NTT-BK20/RaspiTank/raspitank_description/meshes/right_wheel.stl

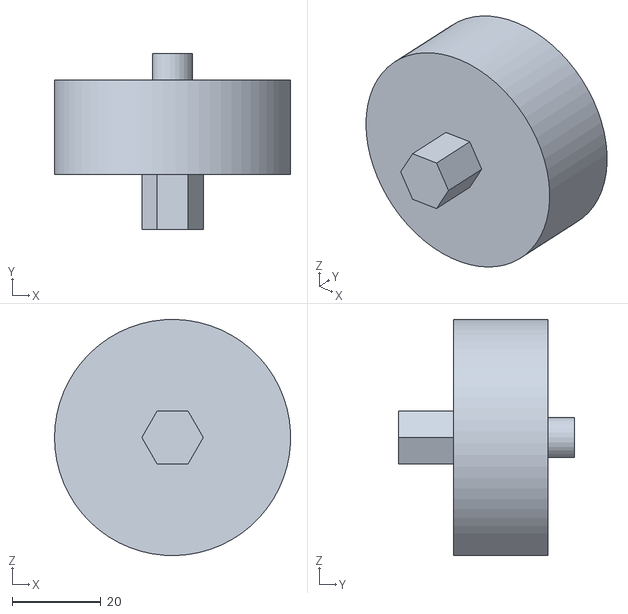
[picture p2: CAD file, 2023-12-18]
raspitank_description/meshes/right_wheel.stl
53.2 x 39.6 x 53.2
