NTT-BK20/RaspiTank/raspitank_description/meshes/chassis.stl

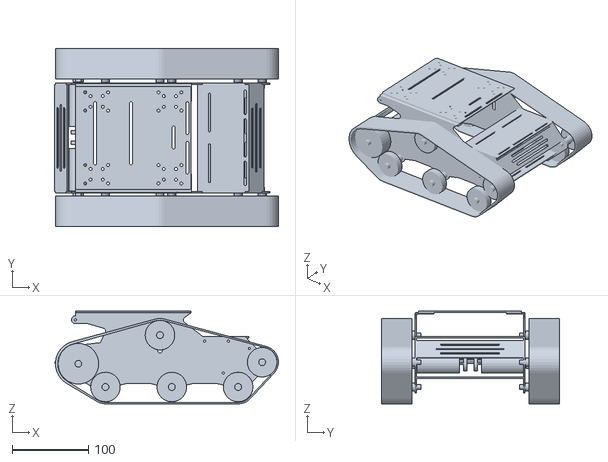
[picture p3: CAD file, 2023-12-18]
raspitank_description/meshes/chassis.stl
293.7 x 234.0 x 121.6
