NTT-BK20/RaspiTank/raspitank_description/meshes/camera.stl

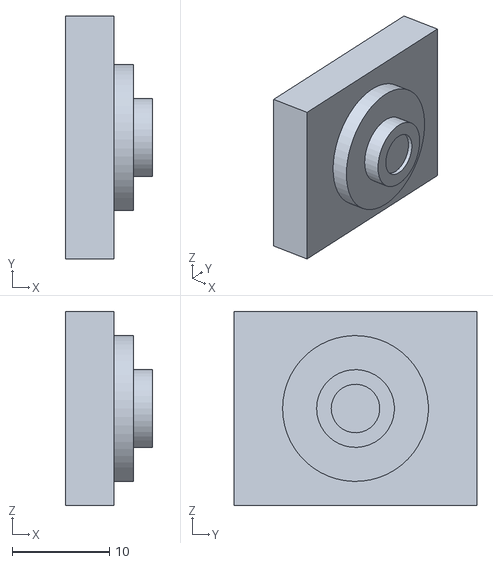
[picture p4: CAD file, 2023-12-18]
raspitank_description/meshes/camera.stl
9.00 x 25.0 x 20.0
