NTT-BK20/RaspiTank/raspitank_description/meshes/laser_frame.stl

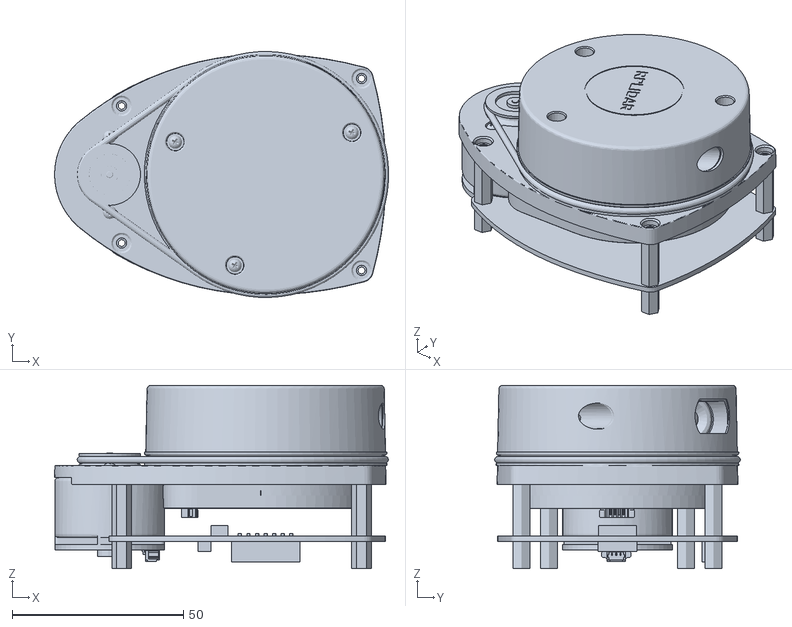
[picture p5: CAD file, 2023-12-18]
raspitank_description/meshes/laser_frame.stl
97.4 x 71.7 x 53.5
