NTT-BK20/RaspiTank/(list of files, cad)

Other CAD files:
raspitank_description/meshes/left_wheel.stl
