NTT-BK20/RaspiTank/raspitank_bringup/config/controllers.yaml

controller_manager: # Node name
  ros__parameters:
    update_rate: 30 # Has to be an integer otherwise errors are encountered

    diff_controller:
      type: diff_drive_controller/DiffDriveController

    joint_broadcaster:
      type: joint_state_broadcaster/JointStateBroadcaster

    imu_broadcaster:
      type: imu_sensor_broadcaster/IMUSensorBroadcaster

diff_controller:
  ros__parameters:
    publish_rate: 50.0 # Has to be a double otherwise errors are encountered

    base_frame_id: base_footprint

    # left_wheel_names: ["left_back_wheel_joint", "left_front_wheel_joint"]
    # right_wheel_names: ["right_back_wheel_joint", "right_front_wheel_joint"]
    left_wheel_names: ["left_wheel_joint"]
    right_wheel_names: ["right_wheel_joint"]
    wheel_separation: 0.2
    wheel_radius: 0.03

    # Obtained from https://wiki.ros.org/diff_drive_controller
    pose_covariance_diagonal:
      [0.001, 0.001, 1000000.0, 1000000.0, 1000000.0, 1000.0]
    twist_covariance_diagonal:
      [0.001, 0.001, 1000000.0, 1000000.0, 1000000.0, 1000.0]

    # Whether the input has a time stamp or not
    use_stamped_vel: false

    # Odometry fused with IMU is published by robot_localization, so no need to publish a TF
    # based on encoders alone (https://wiki.ros.org/diff_drive_controller)
    enable_odom_tf: false

imu_broadcaster:
  ros__parameters:
    sensor_name: mpu6050
    frame_id: imu_link

    # static_covariance_orientation: [0.005, 0.0, 0.0, 0.0, 0.005, 0.0, 0.0, 0.0, 0.005]
    # static_covariance_angular_velocity: [5.76e-04, 0.0, 0.0, 0.0, 5.76e-04, 0.0, 0.0, 0.0, 5.76e-04]
    # static_covariance_linear_acceleration: [9.8067e-03, 0.0, 0.0, 0.0, 9.8067e-03, 0.0, 0.0, 0.0, 9.8067e-03]

    # 500 data points
    static_covariance_orientation:
      [2.63882e-06, 0.0, 0.0, 0.0, 7.50018e-06, 0.0, 0.0, 0.0, 2.89257e-09]
    static_covariance_angular_velocity:
      [2.71413e-07, 0.0, 0.0, 0.0, 6.79488e-07, 0.0, 0.0, 0.0, 4.37879e-07]
    static_covariance_linear_acceleration:
      [0.00133755, 0.0, 0.0, 0.0, 0.000209753, 0.0, 0.0, 0.0, 0.00143276]
