NTT-BK20/RaspiTank/(commit log)

2023-12-18 Version 1.0
    [camera.stl, camera.xacro, chassis.stl, controllers.yaml, diffbot.materials.xacro, diffbot.ros2_control.xacro, diffbot.urdf.xacro, diffbot_controllers.yaml]
2023-12-30 Fix rate
    [ros2_control.xacro]
2024-01-01 Update base_link
    [camera.xacro, controllers.yaml, diffbot_controllers.yaml, gazebo_control.xacro, lidar.xacro, raspitank_core.xacro]
2024-01-14 Update raspitank_base
    [diffbot.materials.xacro, diffbot.ros2_control.xacro, diffbot.urdf.xacro, diffbot_controllers.yaml, diffbot_description.urdf.xacro]
